Board-Folk/Mindscape_Music_Board/isa_bracket.stl

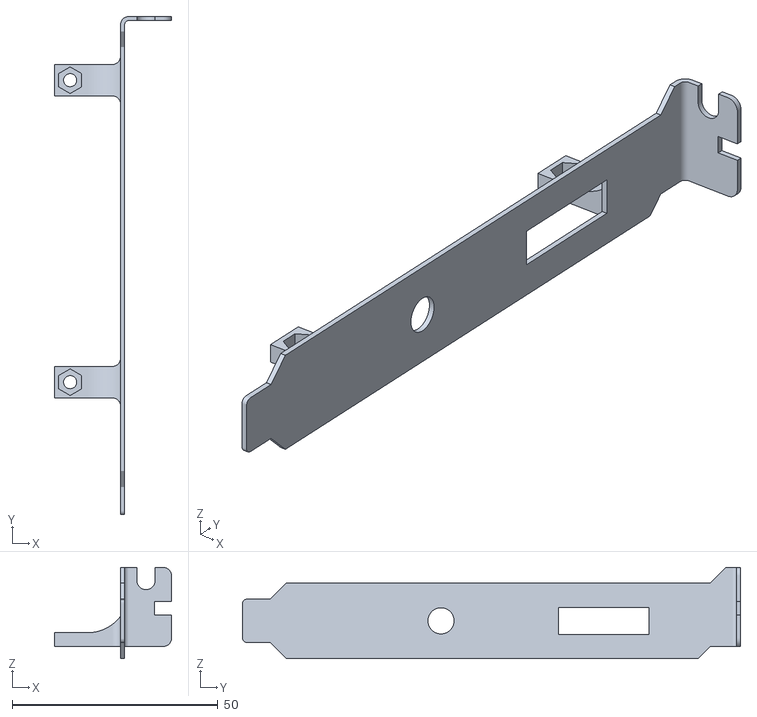
[picture p2: CAD file, 2025-03-28]
isa_bracket.stl
28.4 x 121.0 x 22.1
