Board-Folk/Mindscape_Music_Board/Mindscape_Music_Board.kicad_sch

## KiCad design Mindscape_Music_Board.kicad_sch (2025-09-19)

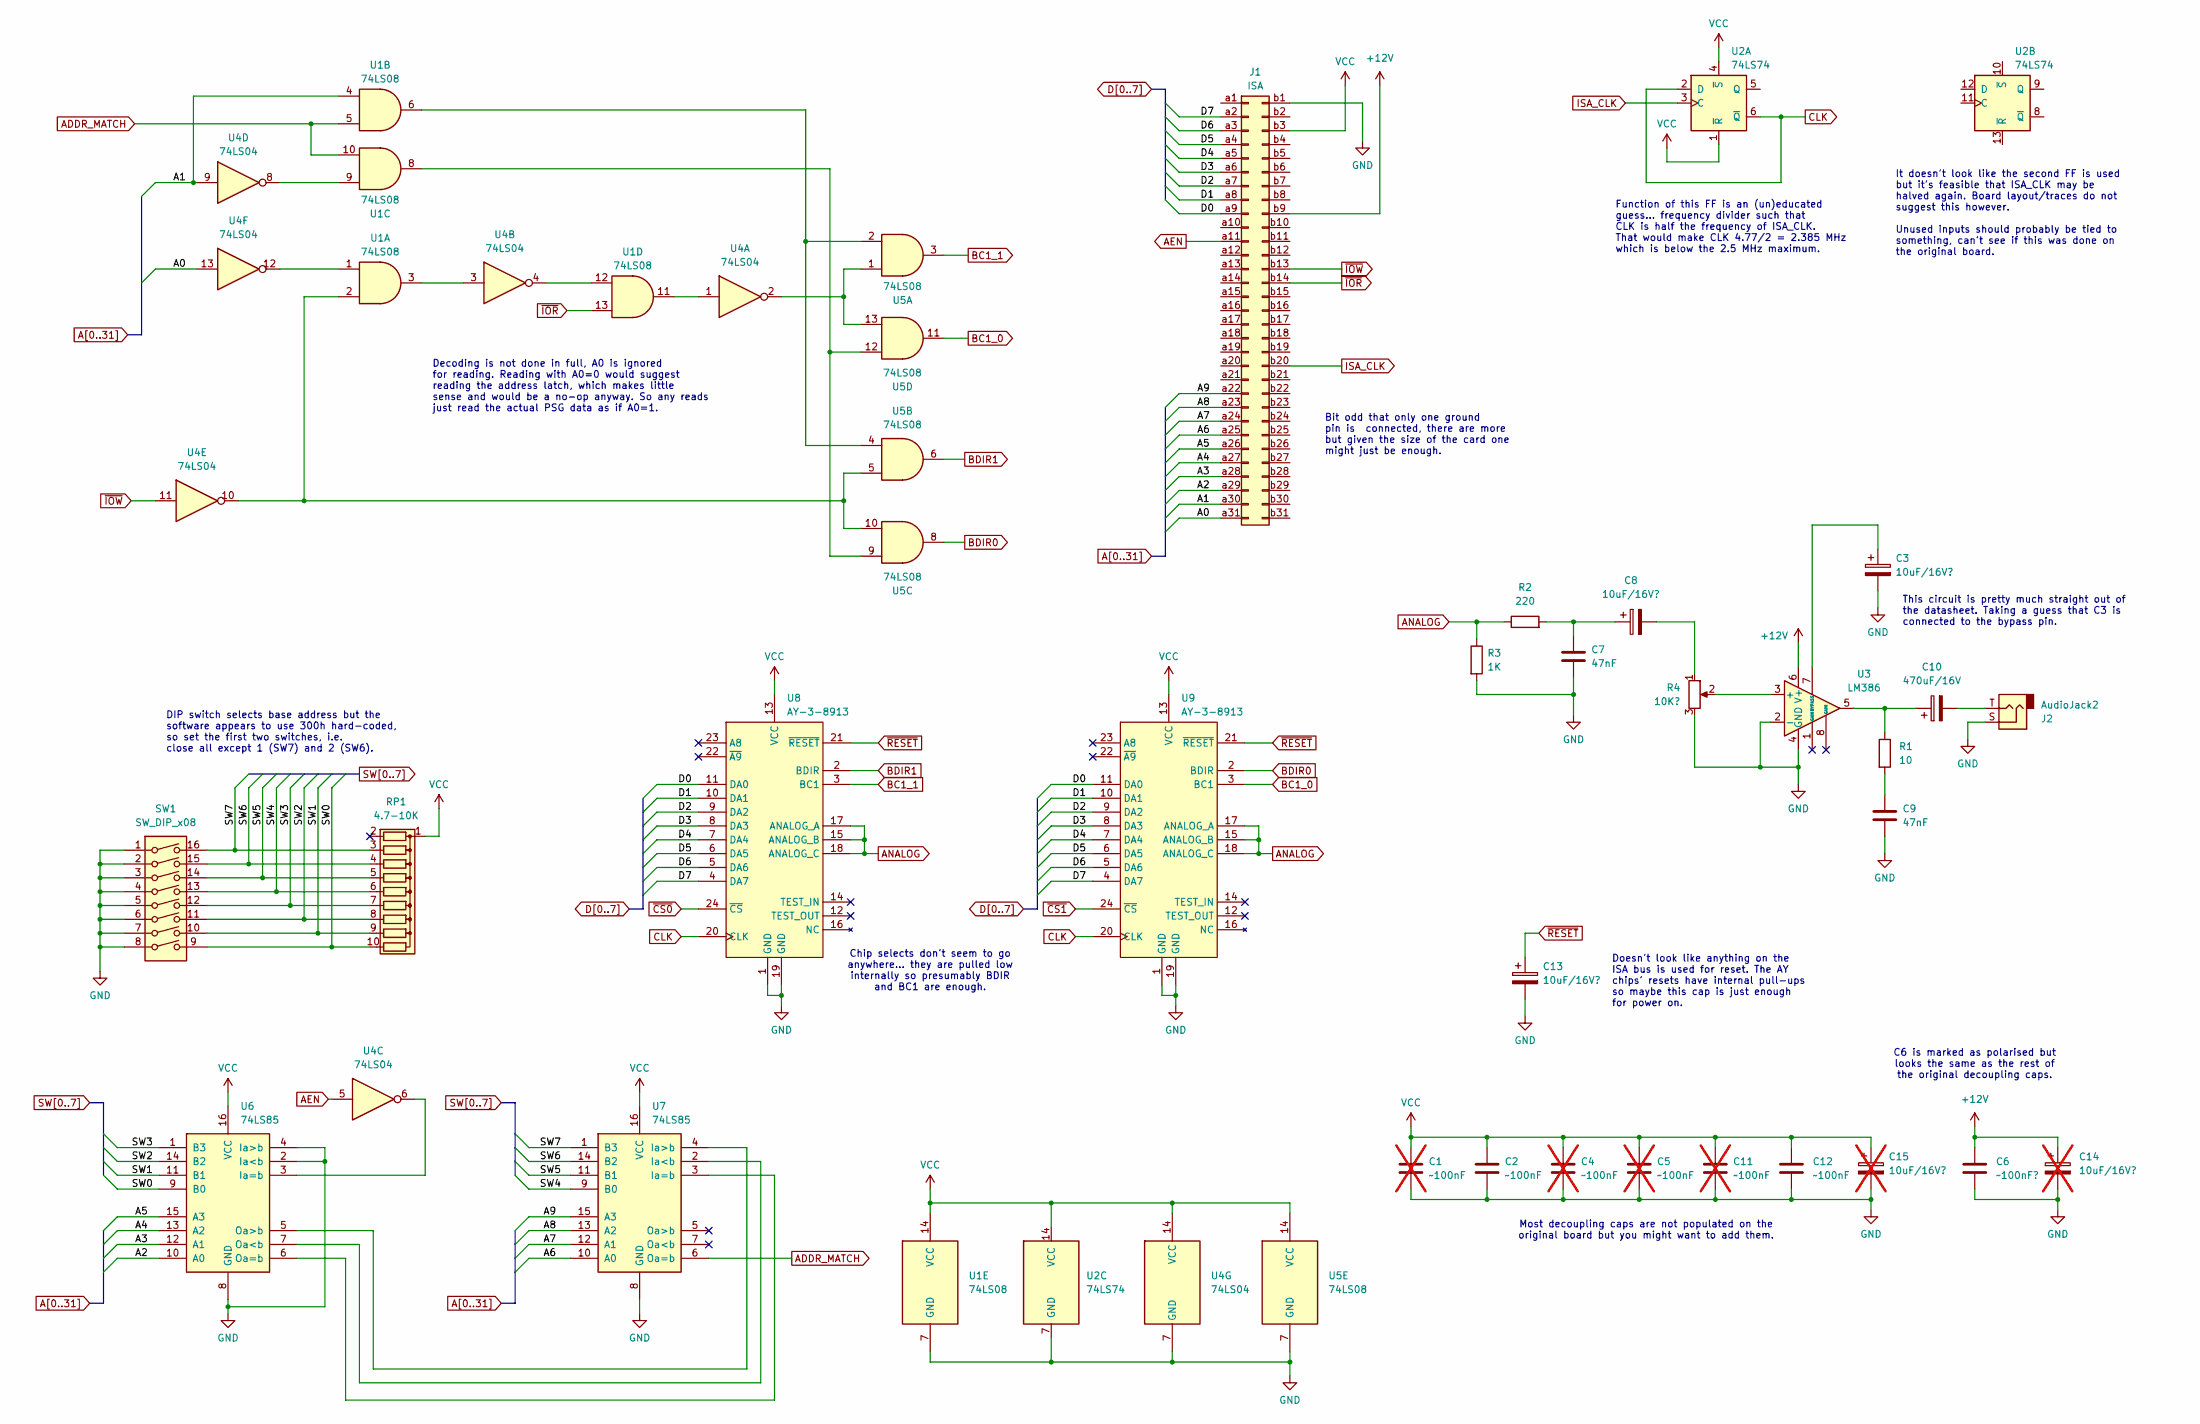
[picture p3: schematic Mindscape_Music_Board.kicad_sch]

Parts:
C1, C4, C5, C11: ~100nF; C_Disc_P7.50mm; not fitted
C2, C12: ~100nF; C_Disc_P7.50mm
C3, C8, C13: 10uF/16V?; CP_Radial_P2.50mm
C6: ~100nF?; CP_Radial_P2.50mm
C7, C9: 47nF; C_Poly_P7.50mm
C10: 470uF/16V; CP_Axial_P25.00mm_Horizontal
C14, C15: 10uF/16V?; CP_Radial_P5.00mm; not fitted
J1: ISA; ISA_Edge
J2: AudioJack2; Audio_Jack
R1: 10; R_P12.70mm
R2: 220; R_P12.70mm
R3: 1K; R_P12.70mm
R4: 10K?; Potentiometer
RP1: 4.7-10K; R_Array_SIP10
SW1: SW_DIP_x08; SW_DIP_SPSTx08
U1, U5: 74LS08; DIP-14_W7.62mm
U2: 74LS74; DIP-14_W7.62mm
U3: LM386; DIP-8_W7.62mm
U4: 74LS04; DIP-14_W7.62mm
U6, U7: 74LS85; DIP-16_W7.62mm
U8, U9: AY-3-8913; DIP-24

Connections:
+12V: C6.1, C14.1, J1.b9, U3.6 (V+)
A0: J1.a31, U4.13
A1: J1.a30, U1.4, U4.9
A2: J1.a29, U6.10 (A0)
A3: J1.a28, U6.12 (A1)
A4: J1.a27, U6.13 (A2)
A5: J1.a26, U6.15 (A3)
A6: J1.a25, U7.10 (A0)
A7: J1.a24, U7.12 (A1)
A8: J1.a23, U7.13 (A2)
A9: J1.a22, U7.15 (A3)
ADDR_MATCH: U1.5, U1.10, U7.6 (Oa=b)
AEN: J1.a11, U4.5
ANALOG: R2.1, R3.1, U8.15 (ANALOG_B), U8.17 (ANALOG_A), U8.18 (ANALOG_C), U9.15 (ANALOG_B), U9.17 (ANALOG_A), U9.18 (ANALOG_C)
BC1_0: U5.11, U9.3 (BC1)
BC1_1: U5.3, U8.3 (BC1)
BDIR0: U5.8, U9.2 (BDIR)
BDIR1: U5.6, U8.2 (BDIR)
CLK: U2.2 (D), U2.6 (~Q), U8.20 (CLK), U9.20 (CLK)
D0: J1.a9, U8.11 (DA0), U9.11 (DA0)
D1: J1.a8, U8.10 (DA1), U9.10 (DA1)
D2: J1.a7, U8.9 (DA2), U9.9 (DA2)
D3: J1.a6, U8.8 (DA3), U9.8 (DA3)
D4: J1.a5, U8.7 (DA4), U9.7 (DA4)
D5: J1.a4, U8.6 (DA5), U9.6 (DA5)
D6: J1.a3, U8.5 (DA6), U9.5 (DA6)
D7: J1.a2, U8.4 (DA7), U9.4 (DA7)
GND: C1.2, C2.2, C3.2, C4.2, C5.2, C6.2, C7.2, C9.2, C11.2, C12.2, C13.2, C14.2, C15.2, J1.b1, J2.S, R3.2, R4.3, SW1.1, SW1.2, SW1.3, SW1.4, SW1.5, SW1.6, SW1.7, SW1.8, U1.7 (GND), U2.7 (GND), U3.2 (-), U3.4 (GND), U4.7 (GND), U5.7 (GND), U6.2 (Ia<b), U6.4 (Ia>b), U6.8 (GND), U7.8 (GND), U8.1 (GND), U8.19 (GND), U9.1 (GND), U9.19 (GND)
ISA_CLK: J1.b20, U2.3 (C)
unnamed: C3.1, U3.7 (BYPASS)
unnamed: C7.1, C8.1, R2.2
unnamed: C8.2, R4.1
unnamed: C9.1, R1.2
unnamed: C10.1, R1.1, U3.5
unnamed: C10.2, J2.T
unnamed: R4.2, U3.3 (+)
unnamed: U1.1, U4.12
unnamed: U1.2, U4.10, U5.5, U5.10
unnamed: U1.3, U4.3
unnamed: U1.6, U5.2, U5.4
unnamed: U1.8, U5.9, U5.12
unnamed: U1.9, U4.8
unnamed: U1.11, U4.1
unnamed: U1.12, U4.4
unnamed: U4.2, U5.1, U5.13
unnamed: U4.6, U6.3 (Ia=b)
unnamed: U6.5 (Oa>b), U7.4 (Ia>b)
unnamed: U6.6 (Oa=b), U7.3 (Ia=b)
unnamed: U6.7 (Oa<b), U7.2 (Ia<b)
SW0: RP1.10 (R9), SW1.9, U6.9 (B0)
SW1: RP1.9 (R8), SW1.10, U6.11 (B1)
SW2: RP1.8 (R7), SW1.11, U6.14 (B2)
SW3: RP1.7 (R6), SW1.12, U6.1 (B3)
SW4: RP1.6 (R5), SW1.13, U7.9 (B0)
SW5: RP1.5 (R4), SW1.14, U7.11 (B1)
SW6: RP1.4 (R3), SW1.15, U7.14 (B2)
SW7: RP1.3 (R2), SW1.16, U7.1 (B3)
VCC: C1.1, C2.1, C4.1, C5.1, C11.1, C12.1, C15.1, J1.b3, RP1.1 (common), U1.14 (VCC), U2.1 (~R), U2.4 (~S), U2.14 (VCC), U4.14 (VCC), U5.14 (VCC), U6.16 (VCC), U7.16 (VCC), U8.13 (VCC), U9.13 (VCC)
~CS0: U8.24 (~CS)
~CS1: U9.24 (~CS)
~IOR: J1.b14, U1.13
~IOW: J1.b13, U4.11
~RESET: C13.1, U8.21 (~RESET), U9.21 (~RESET)

Notes on the sheet:
Doesn't look like anything on the ISA bus is used for reset. The AY chips' resets have internal pull-ups so maybe this cap is just enough for power on.
Chip selects don't seem to go anywhere... they are pulled low internally so presumably BDIR and BC1 are enough.
It doesn't look like the second FF is used but it's feasible that ISA_CLK may be halved again. Board layout/traces do not suggest this however. Unused inputs should probably be tied to something, can't see if this was done on the original board.
Function of this FF is an (un)educated guess... frequency divider such that CLK is half the frequency of ISA_CLK. That would make CLK 4.77/2 = 2.385 MHz which is below the 2.5 MHz maximum.
C6 is marked as polarised but looks the same as the rest of the original decoupling caps.
This circuit is pretty much straight out of the datasheet. Taking a guess that C3 is connected to the bypass pin.
Bit odd that only one ground pin is connected, there are more but given the size of the card one might just be enough.
DIP switch selects base address but the software appears to use 300h hard-coded, so set the first two switches, i.e. close all except 1 (SW7) and 2 (SW6).
Most decoupling caps are not populated on the original board but you might want to add them.
Decoding is not done in full, A0 is ignored for reading. Reading with A0=0 would suggest reading the address latch, which makes little sense and would be a no-op anyway. So any reads just read the actual PSG data as if A0=1.
