Board-Folk/Mindscape_Music_Board/(threads)

Thread 1 (2025-05-26):

Solder mask on ISA edge connector

roybaer, 2025-05-26:
Good afternoon!

I noticed a minor oversight in this reproduction's layout:
There is solder mask on the ISA edge connector, i.e. around its pads, where there is none on the original board, as shown by the embedded reference photographs.
Adjusting this would make the reproduction look even more like the real thing.

P.S.: You might also be interested in my recent works towards Mindscape Music Board support in PCem and Planet X3:
- https://github.com/sarah-walker-pcem/pcem/pull/295
- https://github.com/planet-x3/px3_ose/tree/obscure-hw

SteveMaddison, 2025-09-19:
Thanks for reporting, it's something I recently noticed on a couple of other boards I made but hadn't fixed on this one yet. Should be fixed now, even if it doesn't line up completely accurately.

Nice work adding support for this obscure card to other projects!

Closed 2025-09-19.
