Board-Folk/Mindscape_Music_Board/(commit log)

2025-03-21 More routing/footprints.
    [Mindscape_Music_Board.kicad_sch]
2025-03-24 Worked out glue/decoding (hopefully).
    [Mindscape_Music_Board.kicad_sch]
2025-03-24 Some more accurate footprints.
    [Mindscape_Music_Board.kicad_sch]
2025-03-24 Set gerber path in project.
2025-03-25 Added notes to schematic.
    [Mindscape_Music_Board.kicad_sch]
2025-03-25 Tidying, BOM, annotations.
    [Mindscape_Music_Board.kicad_sch]
2025-03-27 Minor schematic/PCB tweaks.
    [Mindscape_Music_Board.kicad_sch]
2025-03-27 Sync PCB to schematic.
2025-03-28 Add first draft of ISA bracket model.
    [isa_bracket.stl]
2025-09-19 Remove solder mask around card edge contacts (Issue #1).
    [Mindscape_Music_Board.kicad_sch]
